jeremynguyenn/Embedded-Optical-Doorbell-Extender-System/Doorbell Monitoring System/pic_pcb/light-sensor.png

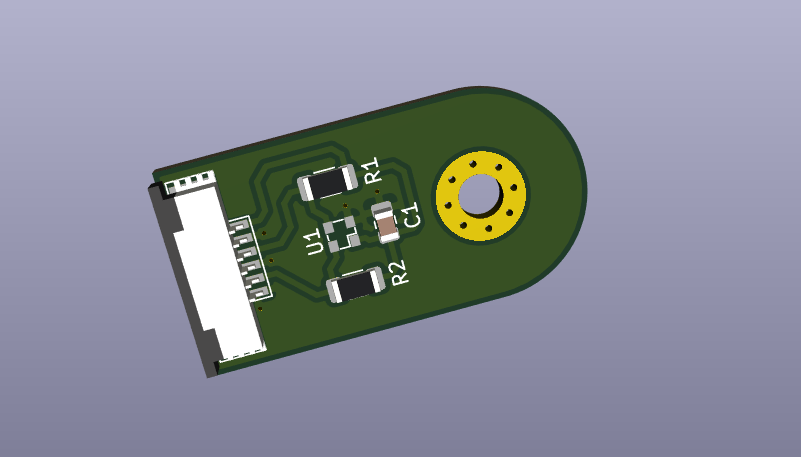
Doorbell Monitoring System/pic_pcb/light-sensor.png
