jeremynguyenn/Embedded-Optical-Doorbell-Extender-System/Doorbell Monitoring System/pic_pcb/doorHandler-transmitter.png

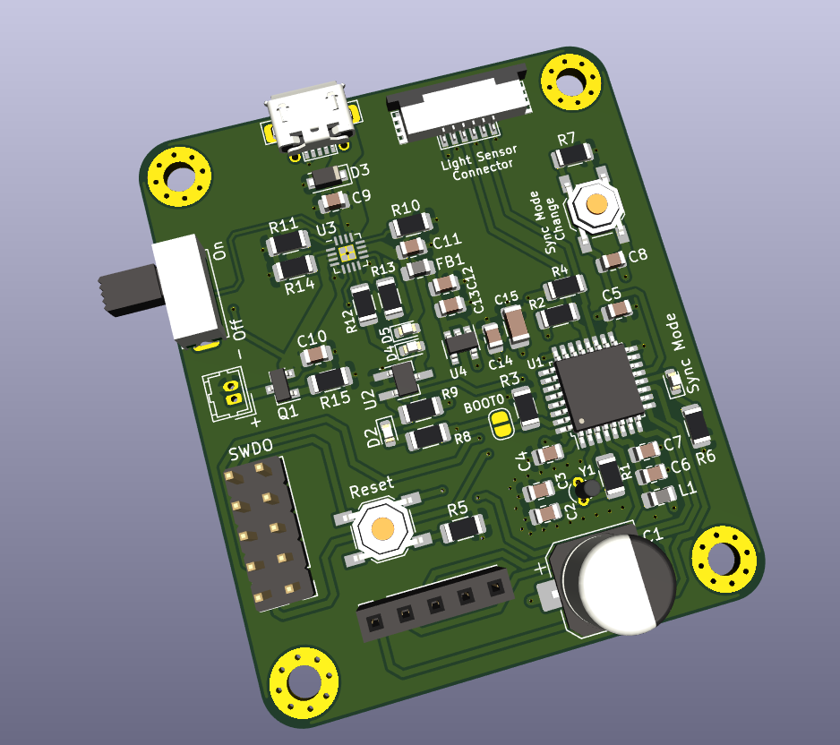
Doorbell Monitoring System/pic_pcb/doorHandler-transmitter.png
