jeremynguyenn/Embedded-Optical-Doorbell-Extender-System/Doorbell Monitoring System/pic_pcb/doorHandler-receiver.png

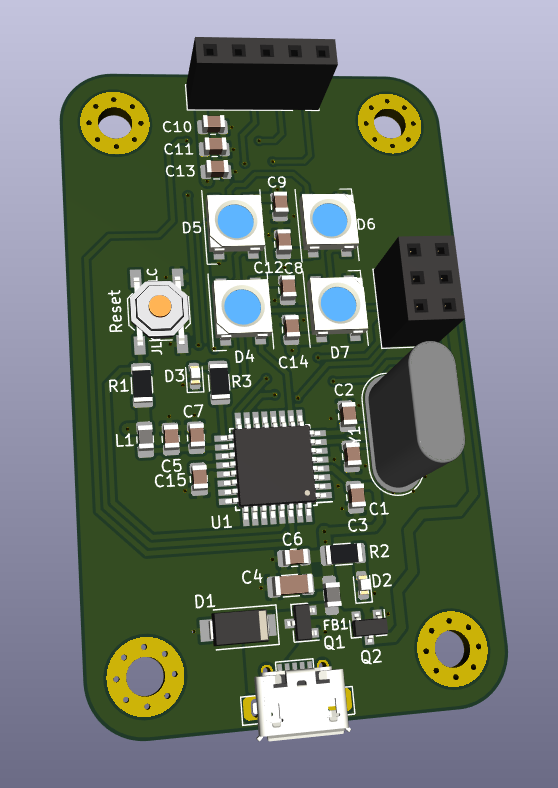
Doorbell Monitoring System/pic_pcb/doorHandler-receiver.png
