jeremynguyenn/Embedded-Optical-Doorbell-Extender-System/Doorbell Monitoring System/design/DoorHandlerLightSensor/DoorHandlerLightSensor.kicad_pcb

## KiCad design Doorbell Monitoring System/design/DoorHandlerLightSensor/DoorHandlerLightSensor.kicad_pcb (2025-09-02)

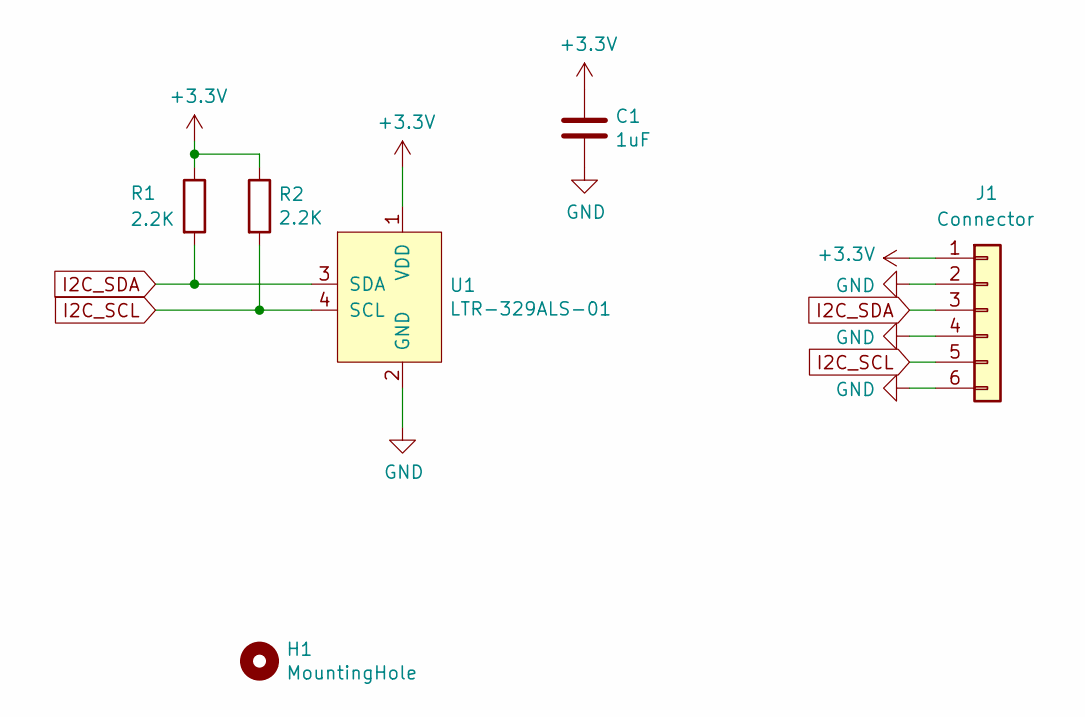
[picture p4: schematic DoorHandlerLightSensor.kicad_sch]

Parts:
C1: 1uF; C_0805_2012Metric
H1: MountingHole; MountingHole_3.2mm_M3_Pad_Via
J1: Connector; AFA07-S06FCA-00
R1, R2: 2.2K; R_1206_3216Metric
U1: LTR-329ALS-01

Connections:
+3V3: C1.1, J1.1, R1.1, R2.1, U1.1 (VDD)
GND: C1.2, J1.2, J1.4, J1.6, U1.2 (GND)
I2C_SCL: J1.5, R2.2, U1.4 (SCL)
I2C_SDA: J1.3, R1.2, U1.3 (SDA)

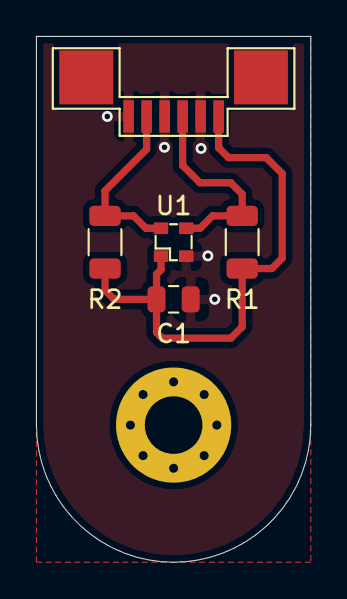
[picture p5: board DoorHandlerLightSensor.kicad_pcb from above]

Board: 2 copper layers, 15.2 x 29.2 mm, 6 parts (0 on the bottom side), 4 nets.
