jeremynguyenn/Embedded-Optical-Doorbell-Extender-System/Doorbell Monitoring System/design/DoorHandlerTransmitter/DoorHandlerTransmitter.kicad_pcb

## KiCad design Doorbell Monitoring System/design/DoorHandlerTransmitter/DoorHandlerTransmitter.kicad_pcb (2025-09-02)

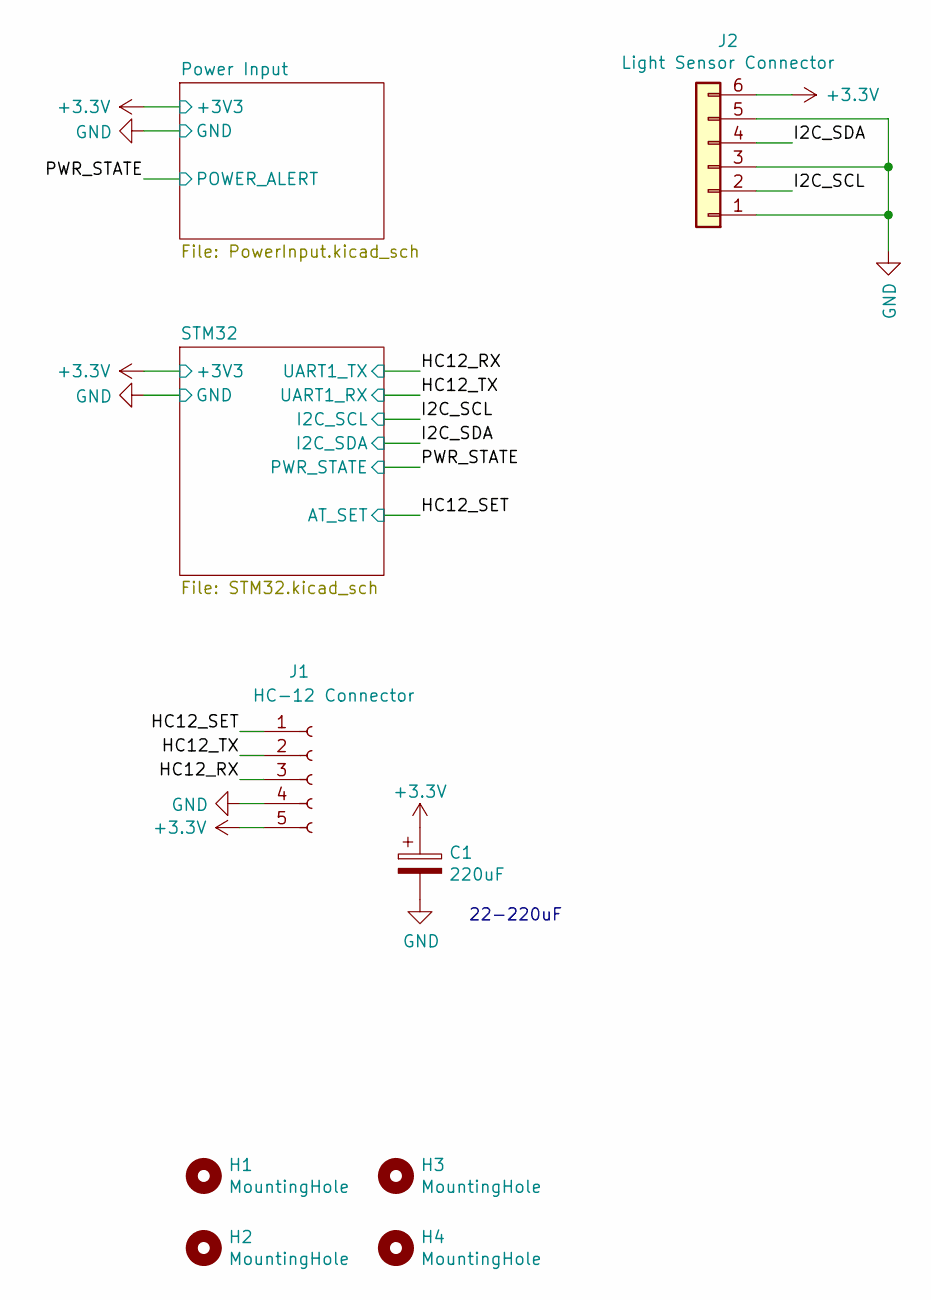
[picture p6: schematic DoorHandlerTransmitter.kicad_sch]

Parts:
C1: 220uF; CP_Elec_8x10.5
H1, H2, H3, H4: MountingHole; MountingHole_3mm_Pad_Via
J1: HC-12 Connector; PinSocket_1x05_P2.54mm_Vertical
J2: Light Sensor Connector; AFA07-S06FCA-00

Connections:
+3V3: C1.1, J1.5, J2.6; also elsewhere on the board
/HC12_RX: J1.3; also elsewhere on the board
/HC12_SET: J1.1; also elsewhere on the board
/HC12_TX: J1.2; also elsewhere on the board
/I2C_SCL: J2.2; also elsewhere on the board
/I2C_SDA: J2.4; also elsewhere on the board
GND: C1.2, J1.4, J2.1, J2.3, J2.5; also elsewhere on the board

Notes on the sheet:
22-220uF

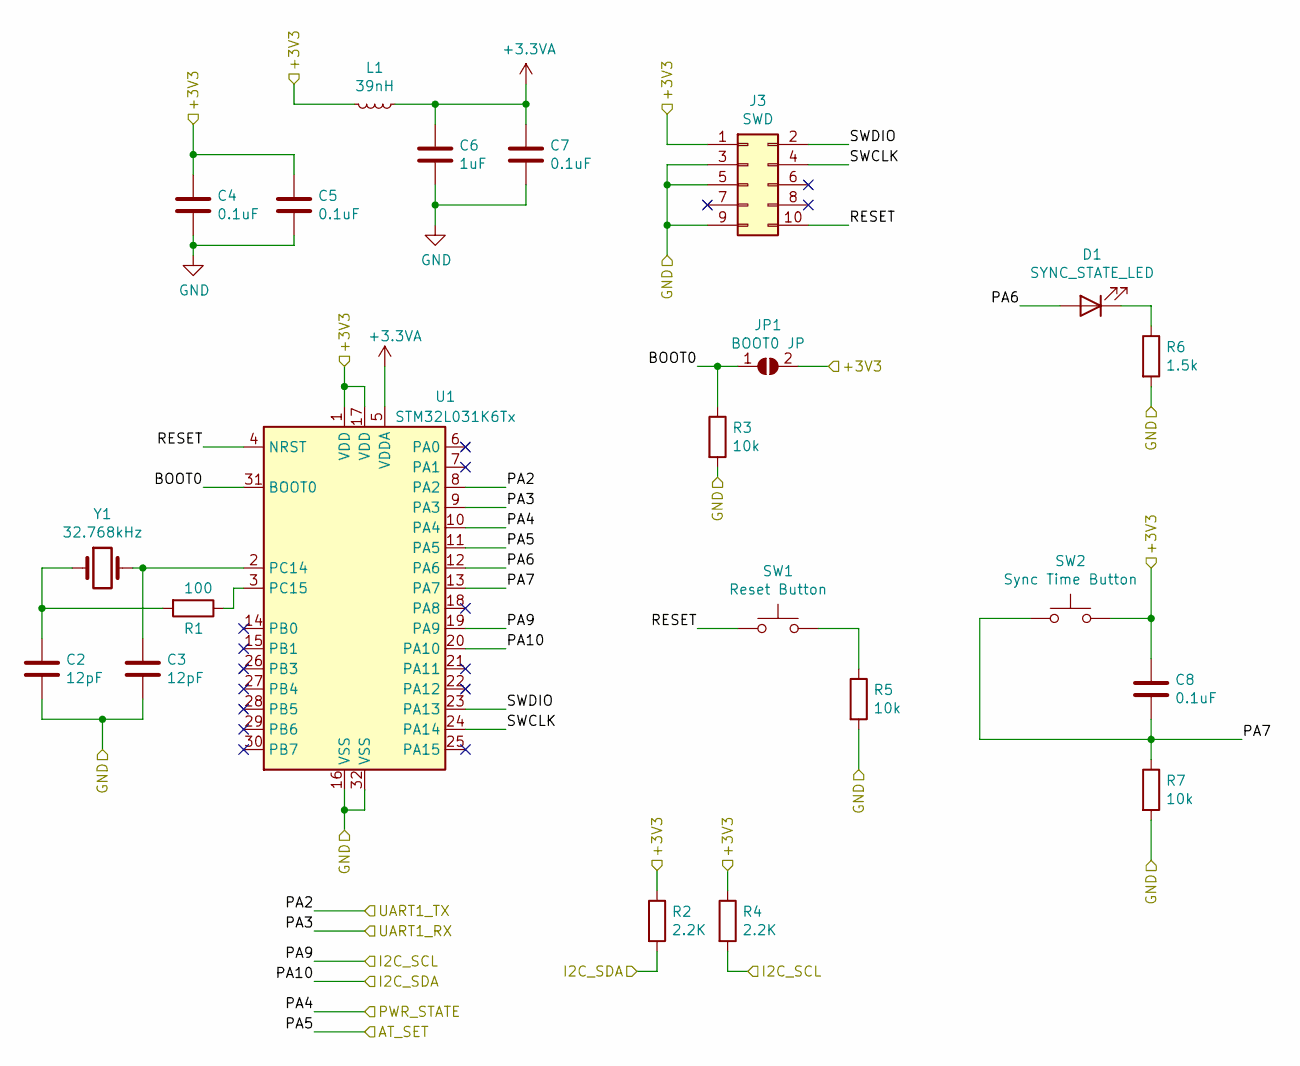
[picture p7: schematic STM32.kicad_sch]

Parts:
C2, C3: 12pF; C_0805_2012Metric
C4, C5, C7, C8: 0.1uF; C_0805_2012Metric
C6: 1uF; C_0805_2012Metric
D1: SYNC_STATE_LED; LED_0603_1608Metric
J3: SWD; PinHeader_2x05_P2.54mm_Vertical
JP1: BOOT0 JP; SolderJumper-2_P1.3mm_Open_RoundedPad1.0x1.5mm
L1: 39nH; L_0805_2012Metric_Pad1.15x1.40mm_HandSolder
R1: 100; R_1206_3216Metric
R2, R4: 2.2K; R_1206_3216Metric
R3, R5, R7: 10k; R_1206_3216Metric
R6: 1.5k; R_1206_3216Metric
SW1: Reset Button; SW_SPST_TL3342
SW2: Sync Time Button; SW_SPST_TL3342
U1: STM32L031K6Tx; LQFP-32_7x7mm_P0.8mm
Y1: 32.768kHz; Crystal_Round_D1.5mm_Vertical

Connections:
+3.3VA: C6.1, C7.1, L1.1, U1.5 (VDDA)
+3V3: C4.1, C5.1, C8.1, J3.1, JP1.2 (B), L1.2, R2.1, R4.1, SW2.2, U1.1 (VDD), U1.17 (VDD); also elsewhere on the board
/HC12_RX: U1.8 (PA2); also elsewhere on the board
/HC12_SET: U1.11 (PA5); also elsewhere on the board
/HC12_TX: U1.9 (PA3); also elsewhere on the board
/I2C_SCL: R4.2, U1.19 (PA9); also elsewhere on the board
/I2C_SDA: R2.2, U1.20 (PA10); also elsewhere on the board
/PWR_STATE: U1.10 (PA4); also elsewhere on the board
/STM32/BOOT0: JP1.1 (A), R3.1, U1.31 (BOOT0)
/STM32/PA6: D1.2 (A), U1.12 (PA6)
/STM32/PA7: C8.2, R7.1, SW2.1, U1.13 (PA7)
/STM32/RESET: J3.10, SW1.1, U1.4 (NRST)
/STM32/SWCLK: J3.4, U1.24 (PA14)
/STM32/SWDIO: J3.2, U1.23 (PA13)
GND: C2.2, C3.2, C4.2, C5.2, C6.2, C7.2, J3.3, J3.5, J3.9, R3.2, R5.2, R6.2, R7.2, U1.16 (VSS), U1.32 (VSS); also elsewhere on the board
unnamed: C2.1, R1.2, Y1.1
unnamed: C3.1, U1.2 (PC14), Y1.2
unnamed: D1.1 (K), R6.1
unnamed: R1.1, U1.3 (PC15)
unnamed: R5.1, SW1.2

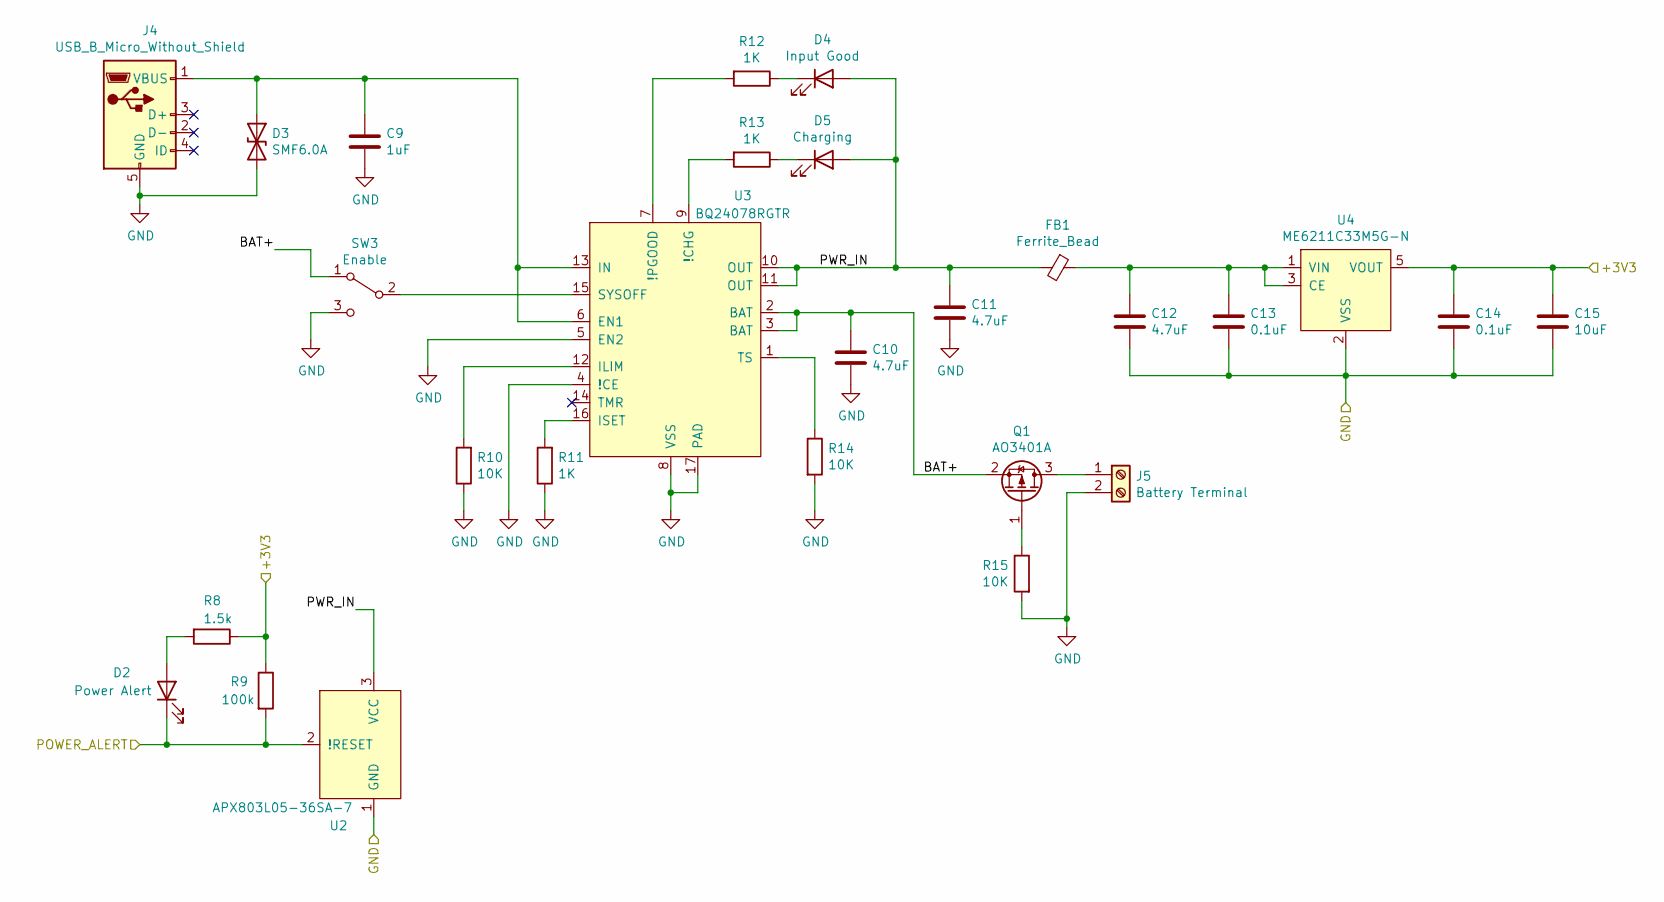
[picture p8: schematic PowerInput.kicad_sch]

Parts:
C9: 1uF; C_0805_2012Metric
C10, C11, C12: 4.7uF; C_0805_2012Metric
C13, C14: 0.1uF; C_0805_2012Metric
C15: 10uF; C_1206_3216Metric
D2: Power Alert; LED_0603_1608Metric
D3: SMF6.0A; D_SOD-123F
D4: Input Good; LED_0603_1608Metric
D5: Charging; LED_0603_1608Metric
FB1: Ferrite_Bead; L_0805_2012Metric_Pad1.15x1.40mm_HandSolder
J4: USB_B_Micro_Without_Shield; Micro_USB_B_Female
J5: Battery Terminal; Hirose_DF13-02P-1.25DSA_1x02_P1.25mm_Vertical
Q1: AO3401A; SOT-23
R8: 1.5k; R_1206_3216Metric
R9: 100k; R_1206_3216Metric
R10, R14, R15: 10K; R_1206_3216Metric
R11, R12, R13: 1K; R_1206_3216Metric
SW3: Enable; Toggle-Switch-SK12D07VG4
U2: APX803L05-36SA-7; SOT-23W_Handsoldering
U3: BQ24078RGTR; VQFN-16-1EP_3x3mm_P0.5mm_EP1.45x1.45mm
U4: ME6211C33M5G-N; SOT-23-5

Connections:
+3V3: C14.1, C15.1, R8.1, R9.1, U4.5 (VOUT); also elsewhere on the board
/PWR_STATE: D2.1 (K), R9.2, U2.2 (!RESET); also elsewhere on the board
/Power Input/BAT+: C10.1, Q1.2 (S), SW3.1 (A), U3.2 (BAT), U3.3 (BAT)
/Power Input/PWR_IN: C11.1, D4.2 (A), D5.2 (A), FB1.2, U2.3 (VCC), U3.10 (OUT), U3.11 (OUT)
GND: C9.2, C10.2, C11.2, C12.2, C13.2, C14.2, C15.2, D3.2 (A2), J4.5 (GND), J5.2, R10.1, R11.1, R14.2, R15.2, SW3.3 (C), U2.1 (GND), U3.4 (!CE), U3.5 (EN2), U3.8 (VSS), U3.17 (PAD), U4.2 (VSS); also elsewhere on the board
unnamed: C9.1, D3.1 (A1), J4.1 (VBUS), U3.6 (EN1), U3.13 (IN)
unnamed: C12.1, C13.1, FB1.1, U4.1 (VIN), U4.3 (CE)
unnamed: D2.2 (A), R8.2
unnamed: D4.1 (K), R12.1
unnamed: D5.1 (K), R13.1
unnamed: J5.1, Q1.3 (D)
unnamed: Q1.1 (G), R15.1
unnamed: R10.2, U3.12 (ILIM)
unnamed: R11.2, U3.16 (ISET)
unnamed: R12.2, U3.7 (!PGOOD)
unnamed: R13.2, U3.9 (!CHG)
unnamed: R14.1, U3.1 (TS)
unnamed: SW3.2 (B), U3.15 (SYSOFF)

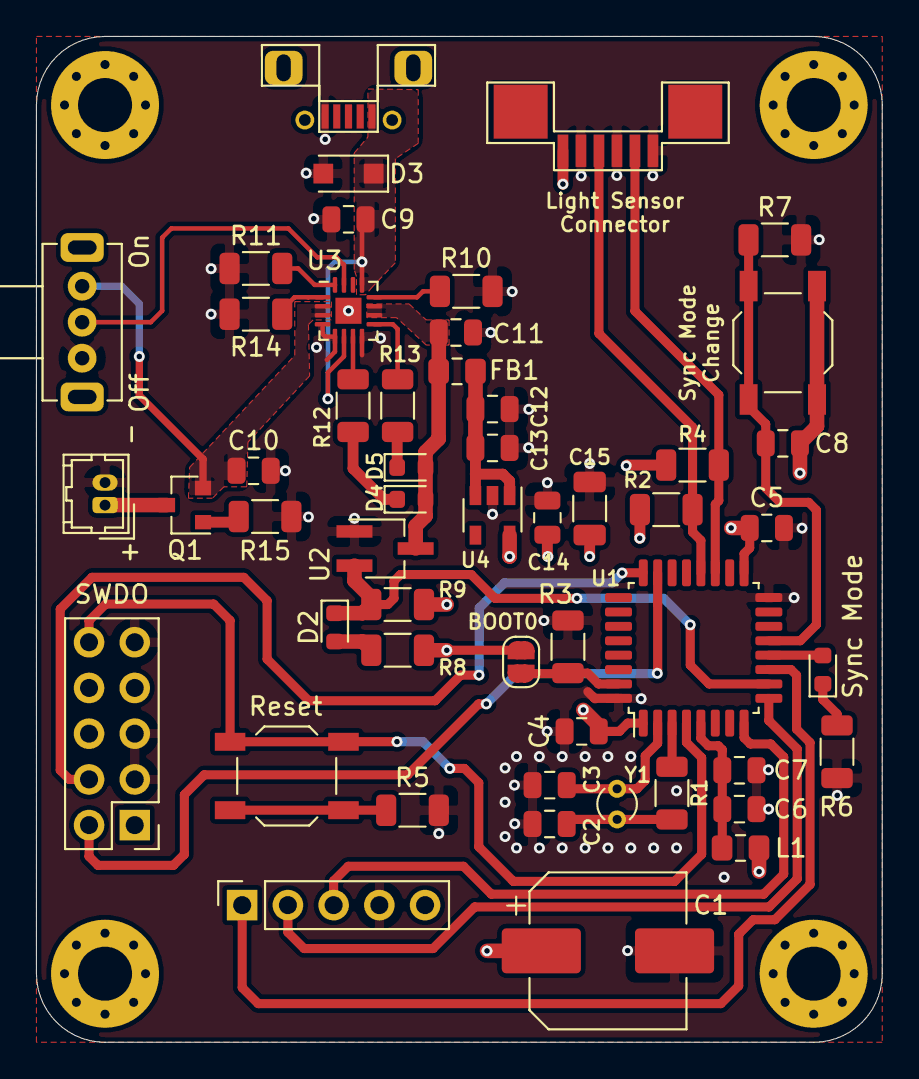
[picture p9: board DoorHandlerTransmitter.kicad_pcb from above]

Board: 4 copper layers, 47.0 x 55.9 mm, 56 parts (0 on the bottom side), 35 nets.
