jeremynguyenn/Embedded-Optical-Doorbell-Extender-System/Doorbell Monitoring System/design/DoorHandlerReceiver/DoorHandlerReceiver.kicad_pcb

## KiCad design Doorbell Monitoring System/design/DoorHandlerReceiver/DoorHandlerReceiver.kicad_pcb (2025-09-02)

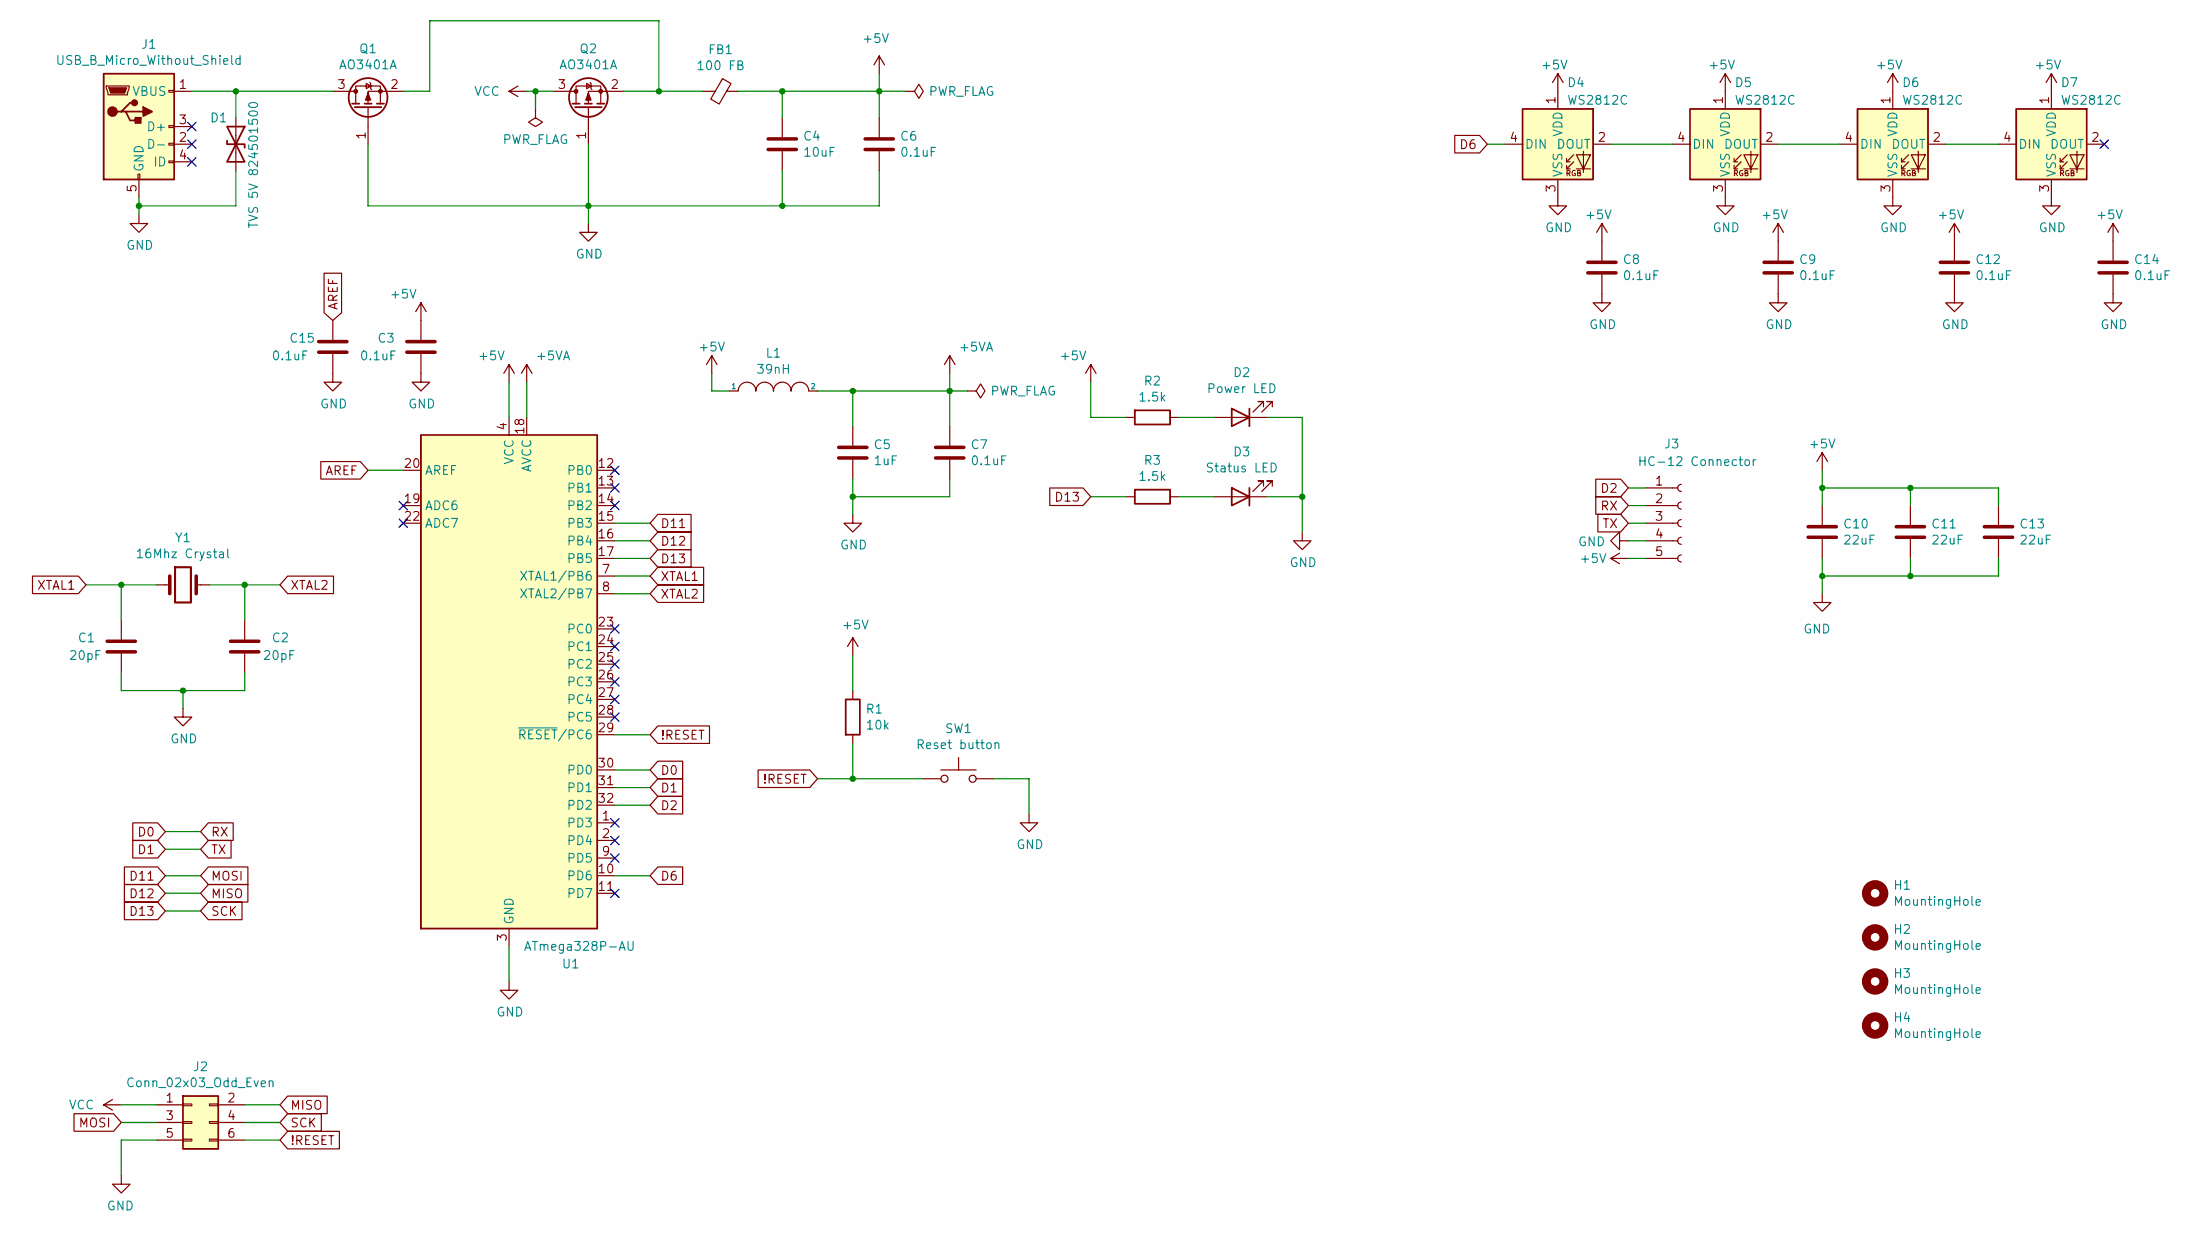
[picture p10: schematic DoorHandlerReceiver.kicad_sch]

Parts:
C1, C2: 20pF; C_0805_2012Metric
C3, C6, C7, C8, C9, C12, C14, C15: 0.1uF; C_0805_2012Metric
C4: 10uF; C_1206_3216Metric
C5: 1uF; C_0805_2012Metric
C10, C11, C13: 22uF; C_0805_2012Metric
D1: TVS 5V 824501500; D_SMA
D2: Power LED; LED_0603_1608Metric
D3: Status LED; LED_0603_1608Metric
D4, D5, D6, D7: WS2812C; LED_WS2812B_PLCC4_5.0x5.0mm_P3.2mm
FB1: 100 FB; L_0805_2012Metric_Pad1.05x1.20mm_HandSolder
H1, H2, H3, H4: MountingHole; MountingHole_3.2mm_M3_Pad_Via
J1: USB_B_Micro_Without_Shield; Micro_USB_B_Female
J2: Conn_02x03_Odd_Even; PinSocket_2x03_P2.54mm_Vertical
J3: HC-12 Connector; PinSocket_1x05_P2.54mm_Vertical
L1: 39nH; L_0805_2012Metric_Pad1.15x1.40mm_HandSolder
Q1, Q2: AO3401A; SOT-23
R1: 10k; R_1206_3216Metric
R2, R3: 1.5k; R_1206_3216Metric
SW1: Reset button; SW_SPST_TL3342
U1: ATmega328P-AU; TQFP-32_7x7mm_P0.8mm
Y1: 16Mhz Crystal; Crystal_HC49-U_Vertical

Connections:
!RESET: J2.6, R1.2, SW1.1, U1.29 (~RESET/PC6)
+5V: C3.1, C4.1, C6.1, C8.1, C9.1, C10.1, C11.1, C12.1, C13.1, C14.1, D4.1 (VDD), D5.1 (VDD), D6.1 (VDD), D7.1 (VDD), FB1.1, J3.5, L1.1, R1.1, R2.2, U1.4 (VCC), U1.6 (VCC)
+5VA: C5.1, C7.1, L1.2, U1.18 (AVCC)
AREF: C15.1, U1.20 (AREF)
D0: J3.2, U1.30 (PD0)
D1: J3.3, U1.31 (PD1)
D2: J3.1, U1.32 (PD2)
D6: D4.4 (DIN), U1.10 (PD6)
D11: J2.3, U1.15 (PB3)
D12: J2.2, U1.16 (PB4)
D13: J2.4, R3.2, U1.17 (PB5)
GND: C1.2, C2.2, C3.2, C4.2, C5.2, C6.2, C7.2, C8.2, C9.2, C10.2, C11.2, C12.2, C13.2, C14.2, C15.2, D1.2 (A2), D2.1 (K), D3.1 (K), D4.3 (VSS), D5.3 (VSS), D6.3 (VSS), D7.3 (VSS), J1.5 (GND), J2.5, J3.4, Q1.1 (G), Q2.1 (G), SW1.2, U1.3 (GND), U1.5 (GND), U1.21 (GND)
unnamed: D1.1 (A1), J1.1 (VBUS), Q1.3 (D)
unnamed: D2.2 (A), R2.1
unnamed: D3.2 (A), R3.1
unnamed: D4.2 (DOUT), D5.4 (DIN)
unnamed: D5.2 (DOUT), D6.4 (DIN)
unnamed: D6.2 (DOUT), D7.4 (DIN)
unnamed: FB1.2, Q1.2 (S), Q2.2 (S)
VCC: J2.1, Q2.3 (D)
XTAL1: C1.1, U1.7 (XTAL1/PB6), Y1.1
XTAL2: C2.1, U1.8 (XTAL2/PB7), Y1.2

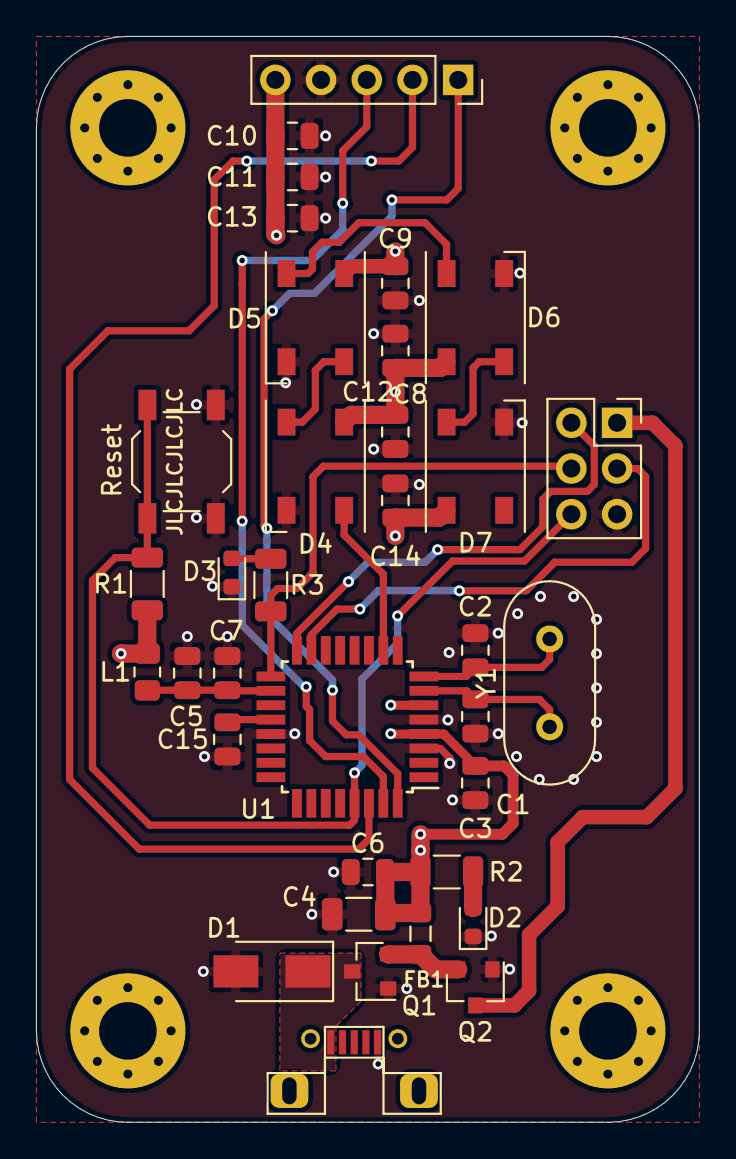
[picture p11: board DoorHandlerReceiver.kicad_pcb from above]

Board: 4 copper layers, 36.8 x 60.3 mm, 39 parts (0 on the bottom side), 22 nets.
