jeremynguyenn/Embedded-Optical-Doorbell-Extender-System/Doorbell Monitoring System/code/door-handler-transmitter/Core/Src/main.c

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
/* Includes ------------------------------------------------------------------*/
#include "main.h"

/* USER CODE BEGIN Includes */
#include "stm32l0xx_it.h"
#include "ltr_329.h"
#include "hc12.h"
/* USER CODE END Includes */

I2C_HandleTypeDef hi2c1;

UART_HandleTypeDef hlpuart1;

TIM_HandleTypeDef htim21;

void SystemClock_Config(void);
static void MX_GPIO_Init(void);
static void MX_I2C1_Init(void);
static void MX_LPUART1_UART_Init(void);
static void MX_TIM21_Init(void);
/**
  * @brief  The application entry point.
  * @retval int
  */
int main(void)
{
  /* MCU Configuration--------------------------------------------------------*/

  /* Reset of all peripherals, Initializes the Flash interface and the Systick. */
  HAL_Init();

  /* Configure the system clock */
  SystemClock_Config();

  /* Initialize all configured peripherals */
  MX_GPIO_Init();
  MX_I2C1_Init();
  MX_LPUART1_UART_Init();
  MX_TIM21_Init();
  /* USER CODE BEGIN 2 */

  // Starting the measurement timer
  IT_setI2CInstance(&hi2c1, &hlpuart1);
  HC12_sleep(&hlpuart1);
  HAL_TIM_Base_Start_IT(&htim21);
  LTR_329_init(&hi2c1);
  LTR_329_writeMeasurementRate(&hi2c1, 0b00100010);

  /* USER CODE END 2 */

  /* Infinite loop */
  /* USER CODE BEGIN WHILE */
  HAL_SuspendTick();
  HAL_PWR_EnableSleepOnExit();
  HAL_PWR_EnterSLEEPMode(PWR_MAINREGULATOR_ON, PWR_SLEEPENTRY_WFI);

  while (1)
  {
    /* USER CODE END WHILE */

    /* USER CODE BEGIN 3 */
	  // With 48x flux:
	  // Light off ch1 = 95 ch0 = 54
	  // Light on ch1 = 1106 ch0 = 822

//	  HAL_Delay(500);
  }
  /* USER CODE END 3 */
}

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
