jeremynguyenn/Embedded-Optical-Doorbell-Extender-System/Doorbell Monitoring System/code/door-handler-transmitter/door-handler-transmitter.ioc

Mcu.UserName=STM32L031K6Ux
PA10.Signal=I2C1_SDA
PA2.Signal=LPUART1_TX
PA3.Signal=LPUART1_RX
PA5.GPIO_Label=AT_SET
PA5.Signal=GPIO_Output
PA6.GPIO_Label=SYNC_STATE_LED
PA6.Signal=GPIO_Output
PA7.GPIO_Label=SYNC_TIME_BTN
PA7.Signal=GPXTI7
PA9.Signal=I2C1_SCL
PC14-OSC32_IN.Signal=RCC_OSC32_IN
PC15-OSC32_OUT.Signal=RCC_OSC32_OUT
