jeremynguyenn/Embedded-Optical-Doorbell-Extender-System/Doorbell Monitoring System/code/door-handler-transmitter/Core/Inc/main.h

#define AT_SET_Pin GPIO_PIN_5
#define AT_SET_GPIO_Port GPIOA
#define SYNC_STATE_LED_Pin GPIO_PIN_6
#define SYNC_STATE_LED_GPIO_Port GPIOA
#define SYNC_TIME_BTN_Pin GPIO_PIN_7
#define SYNC_TIME_BTN_GPIO_Port GPIOA
