jeremynguyenn/Embedded-Optical-Doorbell-Extender-System/(notices)

Notices in the files:
Doorbell Monitoring System/code/door-handler-transmitter/Core/Src/main.c:
Copyright (c) 2022 STMicroelectronics.
All rights reserved.
This software is licensed under terms that can be found in the LICENSE file
